MatiasV98/camara-cultivo-hongos-esp32/datos/crudos/Prueba_Pi_Clasico_Final.txt

⚙️ Configuración - Setpoint: 25.0°C, Kc: 0.650, Ti: 2200s, Ts: 2s, Period: 10000ms

TYPE,Time(s),Temperature(C),Setpoint(C),Error(C),ControlSignal,Integral,RelayState,OnTime(s)
INICIO,0.0,22.69,25.0,0.0,0.000,0,0,0.0
DATA,0.0,22.69,25.0,2.31,1.000,5,0,0.0
🔄 Relay State: OFF | Tiempo en periodo: 0.0s | OnTime: 0.0s
DATA,2.0,22.69,25.0,2.31,1.000,9,0,0.0
🌡️ Temp: 22.69°C | Setpoint: 25.0°C | Error: 2.31
DATA,4.0,22.69,25.0,2.31,1.000,14,0,0.0
🔄 Relay State: OFF | Tiempo en periodo: 5.0s | OnTime: 0.0s
DATA,6.0,22.69,25.0,2.31,1.000,19,0,0.0
DATA,8.0,22.69,25.0,2.31,1.000,23,0,0.0
🔧 Control - Error: 2.31 | Control Signal: 1.000 | OnTime: 10.0s
CLASICO,10.1,22.69,25.0,2.31,1.000,28,0,10.0
DATA,10.1,22.69,25.0,2.31,1.000,28,0,10.0
🔄 Relay State: OFF | Tiempo en periodo: 0.0s | OnTime: 10.0s
🔥 Relay ACTIVADO
DATA,12.1,22.69,25.0,2.31,1.000,32,1,10.0
🌡️ Temp: 22.69°C | Setpoint: 25.0°C | Error: 2.31
DATA,14.1,22.69,25.0,2.31,1.000,37,1,10.0
🔄 Relay State: ON | Tiempo en periodo: 5.0s | OnTime: 10.0s
DATA,16.1,22.69,25.0,2.31,1.000,42,1,10.0
DATA,18.1,22.69,25.0,2.31,1.000,46,1,10.0
🔧 Control - Error: 2.31 | Control Signal: 1.000 | OnTime: 10.0s
CLASICO,20.1,22.69,25.0,2.31,1.000,51,1,10.0
DATA,20.1,22.69,25.0,2.31,1.000,51,1,10.0
🔄 Relay State: ON | Tiempo en periodo: 0.0s | OnTime: 10.0s
DATA,22.1,22.69,25.0,2.31,1.000,56,1,10.0
🌡️ Temp: 22.69°C | Setpoint: 25.0°C | Error: 2.31
DATA,24.1,22.69,25.0,2.31,1.000,60,1,10.0
🔄 Relay State: ON | Tiempo en periodo: 5.0s | OnTime: 10.0s
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
DATA,2753.6,25.19,25.0,-0.19,0.059,613,0,0.0
DATA,2755.6,25.19,25.0,-0.19,0.059,613,0,0.0
🔧 Control - Error: -0.19 | Control Signal: 0.059 | OnTime: 0.0s
CLASICO,2757.6,25.19,25.0,-0.19,0.059,612,0,0.0
DATA,2757.6,25.19,25.0,-0.19,0.059,612,0,0.0
🔄 Relay State: OFF | Tiempo en periodo: 1.0s | OnTime: 0.0s
DATA,2759.6,25.19,25.0,-0.19,0.059,612,0,0.0
🌡️ Temp: 25.19°C | Setpoint: 25.0°C | Error: -0.19
DATA,2761.6,25.19,25.0,-0.19,0.059,612,0,0.0
FIN,2762,25.19,25.0,-0.19,0.059,612,0,0.0
==========================================
⏹️ CONTROL DETENIDO
🌡️ Temperatura final: 25.19°C
📊 Muestras recolectadas: 1378
==========================================
