MatiasV98/camara-cultivo-hongos-esp32/datos/crudos/Prueba_6h.txt

🔬 SISTEMA DE IDENTIFICACIÓN TÉRMICA COMPLETA
==========================================
📟 Sensores DS18B20 detectados: 1
✅ Sensor configurado a 12 bits
🌡️ Temperatura inicial: 21.06°C
📡 Access Point: ESP32-Identificacion
🌐 IP: 192.168.4.1
✅ Servidor web iniciado

💡 NUEVA FUNCIONALIDAD:
• Fase 1: Calentamiento (Peltier ON) por tiempo configurado
• Fase 2: Enfriamiento (Peltier OFF) por tiempo configurado
• Curva completa del sistema térmico
• Análisis de simetría calentamiento/enfriamiento
• Datos por Serial con indicador de fase (C/E)

🎯 Sistema listo - Ve a la IP mostrada arriba
==========================================

⚙️ Configuración - Calentamiento: 360 min, Enfriamiento: 1 min, Intervalo: 5 seg

🚀 INICIANDO PRUEBA COMPLETA DE IDENTIFICACIÓN
==========================================
⏰ Fase Calentamiento: 360 minutos
⏰ Fase Enfriamiento: 1 minutos
📊 Intervalo de muestreo: 5 segundos
Tiempo(s),Temperatura(C),Fase
0.0,21.06,C
1.3,21.06,C
6.3,21.06,C
11.3,21.06,C
16.3,21.06,C
21.3,21.06,C
26.4,21.06,C
31.4,21.06,C
36.4,21.06,C
41.4,21.06,C
46.4,21.06,C
51.4,21.06,C
56.4,21.06,C
61.4,21.06,C
66.4,21.06,C
71.4,21.06,C
76.4,21.12,C
81.4,21.12,C
86.4,21.12,C
91.4,21.12,C
96.4,21.19,C
101.4,21.25,C
106.4,21.25,C
111.4,21.31,C
116.5,21.38,C
121.5,21.44,C
126.5,21.44,C
131.5,21.50,C
136.5,21.56,C
141.5,21.56,C
146.5,21.62,C
151.5,21.69,C
156.5,21.69,C
161.5,21.69,C
166.5,21.75,C
171.5,21.75,C
176.5,21.81,C
181.5,21.88,C
186.5,21.88,C
191.5,21.94,C
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

==========================================
✅ PRUEBA COMPLETA FINALIZADA
⏰ Tiempo total: 21668.5 segundos
🌡️ Temperatura final: 45.25°C
📊 Muestras recolectadas: 4332
📈 Ganancia en calentamiento: 24.25°C
==========================================
