MatiasV98/camara-cultivo-hongos-esp32/datos/crudos/Prueba_Final_PI_IMC.txt

=
ðŸŽ›ï¸ INICIANDO CONTROLADOR PI
==========================================
ðŸŽ¯ Setpoint: 25.0Â°C
ðŸ”§ ParÃ¡metros - Kc: 0.600, Ti: 2200s, Ts: 2s
â° Periodo control: 10000ms
TYPE,Time(s),Temperature(C),Setpoint(C),Error(C),ControlSignal,Integral,RelayState,OnTime(s)
INICIO,0.0,22.00,25.0,0.0,0.000,0,0,0.0
DATA,0.0,22.00,25.0,3.00,1.000,6,0,0.0
DATA,2.0,22.00,25.0,3.00,1.000,12,0,0.0
DATA,4.0,22.00,25.0,3.00,1.000,18,0,0.0
DATA,6.1,22.00,25.0,3.00,1.000,24,0,0.0
DATA,8.1,22.00,25.0,3.00,1.000,30,0,0.0
CONTROL,10.1,22.00,25.0,3.00,1.000,36,0,10.0
DATA,10.1,22.00,25.0,3.00,1.000,36,0,10.0
DATA,12.1,22.00,25.0,3.00,1.000,42,1,10.0
DATA,14.1,22.00,25.0,3.00,1.000,48,1,10.0
DATA,16.1,22.00,25.0,3.00,1.000,54,1,10.0
DATA,18.1,22.00,25.0,3.00,1.000,60,1,10.0
CONTROL,20.1,22.00,25.0,3.00,1.000,66,0,10.0
DATA,20.1,22.00,25.0,3.00,1.000,66,0,10.0
DATA,22.1,22.00,25.0,3.00,1.000,72,1,10.0
DATA,24.1,22.00,25.0,3.00,1.000,78,1,10.0
DATA,26.1,22.00,25.0,3.00,1.000,84,1,10.0
DATA,28.1,22.00,25.0,3.00,1.000,90,1,10.0
CONTROL,30.1,22.00,25.0,3.00,1.000,96,0,10.0
DATA,30.1,22.00,25.0,3.00,1.000,96,0,10.0
DATA,32.2,22.00,25.0,3.00,1.000,102,1,10.0
DATA,34.2,22.00,25.0,3.00,1.000,108,1,10.0
DATA,36.2,22.00,25.0,3.00,1.000,114,1,10.0
DATA,38.2,22.00,25.0,3.00,1.000,120,1,10.0
CONTROL,40.2,22.00,25.0,3.00,1.000,126,0,10.0
DATA,40.2,22.00,25.0,3.00,1.000,126,0,10.0
DATA,42.2,22.00,25.0,3.00,1.000,132,1,10.0
DATA,44.2,22.00,25.0,3.00,1.000,138,1,10.0
DATA,46.2,22.00,25.0,3.00,1.000,144,1,10.0
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
DATA,2193.1,25.25,25.0,-0.25,0.078,835,0,0.0
DATA,2195.1,25.25,25.0,-0.25,0.078,834,0,0.0
DATA,2197.1,25.25,25.0,-0.25,0.077,834,0,0.0
CONTROL,2199.1,25.25,25.0,-0.25,0.077,833,0,0.0
DATA,2199.1,25.25,25.0,-0.25,0.077,833,0,0.0
DATA,2201.1,25.25,25.0,-0.25,0.077,833,0,0.0
DATA,2203.1,25.25,25.0,-0.25,0.077,832,0,0.0
FIN,2204,25.25,25.0,-0.25,0.077,832,0,0.0
==========================================
â¹ï¸ CONTROL DETENIDO
ðŸŒ¡ï¸ Temperatura final: 25.25Â°C
ðŸ“Š Muestras recolectadas: 1098
==========================================
