MatiasV98/camara-cultivo-hongos-esp32/datos/crudos/Prueba_PI.txt

ðŸŽ›ï¸ INICIANDO CONTROLADOR PI
==========================================
ðŸŽ¯ Setpoint: 22.0Â°C
ðŸ”§ ParÃ¡metros - Kc: 0.700, Ti: 2403s, Ts: 2s
â° Periodo control: 10000ms
TYPE,Time(s),Temperature(C),Setpoint(C),Error(C),ControlSignal,Integral,RelayState,OnTime(s)
INICIO,0.0,19.75,22.0,0.0,0.000,0,0,0.0
DATA,0.0,19.75,22.0,2.25,1.000,5,0,10.0
DATA,2.0,19.81,22.0,2.19,1.000,9,1,10.0
DATA,4.1,19.81,22.0,2.19,1.000,13,1,10.0
DATA,6.1,19.81,22.0,2.19,1.000,18,1,10.0
DATA,8.1,19.87,22.0,2.12,1.000,22,1,10.0
CONTROL,10.9,19.87,22.0,2.12,1.000,26,0,10.0
DATA,10.1,19.87,22.0,2.12,1.000,26,0,10.0
DATA,12.1,19.87,22.0,2.12,1.000,30,1,10.0
DATA,14.1,19.87,22.0,2.12,1.000,35,1,10.0
DATA,16.1,19.87,22.0,2.12,1.000,39,1,10.0
DATA,18.1,19.94,22.0,2.06,1.000,43,1,10.0
ÿÿÿÿÿÿÿÿÿÿÿÿÿÿÿÿÿÿÿÿÿÿÿÿÿÿÿÿÿÿÿÿÿÿÿÿÿÿÿÿÿÿÿÿÿÿÿÿÿÿÿÿÿÿÿÿÿÿÿÿÿÿÿÿONTROL,20.9,19.94,22.0,2.06,1.000,47,1,10.0
DATA,20.1,19.94,22.0,2.06,1.000,47,1,10.0
DATA,22.1,20.00,22.0,2.00,1.000,51,1,10.0
DATA,24.1,20.00,22.0,2.00,1.000,55,1,10.0
DATA,26.1,20.00,22.0,2.00,1.000,59,1,10.0
DATA,28.1,20.00,22.0,2.00,1.000,63,1,10.0
CONTROL,30.9,20.00,22.0,2.00,1.000,67,1,10.0
DATA,30.1,20.00,22.0,2.00,1.000,67,1,10.0
DATA,32.2,20.00,22.0,2.00,1.000,71,1,10.0
DATA,34.2,20.06,22.0,1.94,1.000,75,1,10.0
DATA,36.2,20.06,22.0,1.94,1.000,79,1,10.0
DATA,38.2,20.06,22.0,1.94,1.000,83,1,10.0
CONTROL,41.0,20.12,22.0,1.87,1.000,87,1,10.0
DATA,40.2,20.12,22.0,1.87,1.000,87,1,10.0
DATA,42.2,20.12,22.0,1.87,1.000,90,1,10.0
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
DATA,2240.5,22.12,22.0,-0.13,0.154,827,0,0.0
FIN,2243,22.12,22.0,-0.13,0.154,827,0,0.0
==========================================
â¹ï¸ CONTROL DETENIDO
ðŸŒ¡ï¸ Temperatura final: 22.12Â°C
ðŸ“Š Muestras recolectadas: 1118
==========================================
