MatiasV98/camara-cultivo-hongos-esp32/datos/identificacion/prueba1_100min.csv

Tiempo_s | Temperatura_C
0 | 16.12
1.1 | 16.19
3.2 | 16.12
5.2 | 16.12
7.2 | 16.19
9.2 | 16.12
11.2 | 16.19
13.2 | 16.12
15.2 | 16.19
17.2 | 16.19
19.2 | 16.12
21.2 | 16.19
23.2 | 16.12
25.2 | 16.12
27.2 | 16.12
29.2 | 16.12
31.2 | 16.19
33.3 | 16.12
35.3 | 16.19
37.3 | 16.19
39.3 | 16.19
41.3 | 16.19
43.3 | 16.19
45.3 | 16.19
47.3 | 16.19
49.3 | 16.25
51.3 | 16.25
53.3 | 16.25
55.3 | 16.31
57.3 | 16.31
59.3 | 16.31
61.3 | 16.31
63.3 | 16.31
65.3 | 16.31
67.3 | 16.31
69.3 | 16.31
71.3 | 16.31
73.4 | 16.31
75.4 | 16.31
77.4 | 16.25
79.4 | 16.25
81.4 | 16.25
83.4 | 16.25
85.4 | 16.25
87.4 | 16.25
89.4 | 16.25
91.4 | 16.31
93.4 | 16.31
95.4 | 16.31
97.4 | 16.31
99.4 | 16.38
101.4 | 16.38
103.4 | 16.38
105.4 | 16.44
107.4 | 16.38
109.4 | 16.44
111.4 | 16.44
113.5 | 16.5
115.5 | 16.5
117.5 | 16.5
119.5 | 16.56
121.5 | 16.56
123.5 | 16.56
125.5 | 16.62
127.5 | 16.56
129.5 | 16.62
131.5 | 16.62
133.5 | 16.69
135.5 | 16.69
137.5 | 16.69
139.5 | 16.69
141.5 | 16.75
143.5 | 16.81
145.6 | 16.81
147.6 | 16.81
149.6 | 16.81
151.6 | 16.88
153.6 | 16.81
155.6 | 16.88
157.6 | 16.94
159.6 | 16.94
161.6 | 16.94
163.6 | 16.94
165.6 | 16.94
167.6 | 17
169.6 | 17
171.6 | 17
173.6 | 17
175.6 | 17
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
