MatiasV98/camara-cultivo-hongos-esp32/datos/identificacion/prueba2_240min.csv

Tiempo_s | Temperatura_C
0 | 17.88
1.2 | 17.88
3.2 | 17.88
5.2 | 17.81
7.2 | 17.88
9.2 | 17.88
11.2 | 17.81
13.2 | 17.88
15.2 | 17.88
17.2 | 17.88
19.2 | 17.81
21.2 | 17.81
23.2 | 17.88
25.2 | 17.88
27.2 | 17.81
29.3 | 17.88
31.3 | 17.88
35.3 | 17.88
37.3 | 17.81
39.3 | 17.88
41.3 | 17.81
43.3 | 17.88
45.3 | 17.88
47.3 | 17.88
49.3 | 17.88
51.3 | 17.81
53.3 | 17.88
55.3 | 17.88
57.3 | 17.88
59.3 | 17.88
61.4 | 17.88
63.4 | 17.88
65.4 | 17.88
67.4 | 17.88
69.4 | 17.88
71.4 | 17.81
73.4 | 17.88
77.4 | 17.88
79.4 | 17.88
83.4 | 17.88
85.4 | 17.94
87.4 | 17.94
89.4 | 17.94
91.4 | 17.94
93.4 | 18
95.4 | 18
97.4 | 18
99.4 | 18
101.4 | 18.06
103.4 | 18.06
105.4 | 18.12
107.5 | 18.12
109.5 | 18.12
111.5 | 18.19
113.5 | 18.19
115.5 | 18.19
117.5 | 18.25
119.5 | 18.25
121.5 | 18.25
123.5 | 18.31
125.5 | 18.31
127.5 | 18.31
129.5 | 18.31
131.5 | 18.38
133.5 | 18.38
135.6 | 18.38
137.6 | 18.38
139.6 | 18.44
141.6 | 18.44
143.6 | 18.44
145.6 | 18.44
147.6 | 18.5
149.6 | 18.5
151.6 | 18.5
153.6 | 18.5
155.6 | 18.56
157.7 | 18.56
161.7 | 18.56
163.7 | 18.62
165.7 | 18.62
167.7 | 18.62
169.7 | 18.69
171.7 | 18.69
173.7 | 18.69
175.7 | 18.69
177.7 | 18.69
179.8 | 18.75
181.8 | 18.75
183.8 | 18.75
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
