MatiasV98/camara-cultivo-hongos-esp32/datos/identificacion/prueba3_360min_completa.csv

Tiempo_s | Temperatura_C | Fase
0 | 21.06 | C
1.3 | 21.06 | C
6.3 | 21.06 | C
11.3 | 21.06 | C
16.3 | 21.06 | C
21.3 | 21.06 | C
26.4 | 21.06 | C
31.4 | 21.06 | C
36.4 | 21.06 | C
41.4 | 21.06 | C
46.4 | 21.06 | C
51.4 | 21.06 | C
56.4 | 21.06 | C
61.4 | 21.06 | C
66.4 | 21.06 | C
71.4 | 21.06 | C
76.4 | 21.12 | C
81.4 | 21.12 | C
86.4 | 21.12 | C
91.4 | 21.12 | C
96.4 | 21.19 | C
101.4 | 21.25 | C
106.4 | 21.25 | C
111.4 | 21.31 | C
116.5 | 21.38 | C
121.5 | 21.44 | C
126.5 | 21.44 | C
131.5 | 21.5 | C
136.5 | 21.56 | C
141.5 | 21.56 | C
146.5 | 21.62 | C
151.5 | 21.69 | C
156.5 | 21.69 | C
161.5 | 21.69 | C
166.5 | 21.75 | C
171.5 | 21.75 | C
176.5 | 21.81 | C
181.5 | 21.88 | C
186.5 | 21.88 | C
191.5 | 21.94 | C
196.5 | 21.94 | C
201.5 | 22 | C
206.5 | 22.06 | C
211.5 | 22.06 | C
216.5 | 22.12 | C
221.6 | 22.19 | C
226.6 | 22.19 | C
231.6 | 22.25 | C
236.6 | 22.31 | C
241.6 | 22.31 | C
246.6 | 22.38 | C
251.6 | 22.44 | C
256.6 | 22.44 | C
261.6 | 22.5 | C
266.6 | 22.5 | C
271.6 | 22.56 | C
276.6 | 22.56 | C
281.6 | 22.62 | C
286.6 | 22.62 | C
291.6 | 22.69 | C
296.6 | 22.69 | C
301.6 | 22.75 | C
306.6 | 22.81 | C
311.6 | 22.81 | C
316.6 | 22.88 | C
321.6 | 22.88 | C
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
