MatiasV98/camara-cultivo-hongos-esp32/(commit log)

2026-11-01 Firmware PI IMC (ESP32)
2026-11-01 Firmware con selección IMC / clásico (ESP32)
2026-11-01 Scripts de MATLAB: limpieza, ajuste FOPTD, Bode y LGR
2026-11-01 Datos de los ensayos al escalón (identificación)
    [prueba1_100min.csv, prueba2_240min.csv, prueba3_240min.csv, prueba3_360min_completa.csv]
2026-11-01 Datos de los ensayos con PI en lazo cerrado
    [pi_kc0.65_ti2200_sp25.csv, pi_kc0.6_ti2200_sp25.csv, pi_kc0.7_ti2400_sp22.csv]
2026-11-01 Registros seriales originales del ESP32
2026-11-01 README: el proyecto es la cámara de cultivo de hongos
2026-11-07 README: métricas de los ensayos, actuador y ajuste en planta; firmware sin emojis
    - Tabla con llegada a la consigna, máximo sobre SP, recuperación ante la
    perturbación y estado final, calculados de los CSV de lazo cerrado.
    - Se explica que el relé quedó en todo-nada (período 10 s, mínimos de 5 s)
    y por qué las ganancias en planta superan a las de diseño.
    - Notación K_c (IMC) / K_p (clásico) igual a la del informe.
    - Mensajes seriales y página web del ESP32 sin emojis.
2026-11-07 README: sección de contacto con el mismo formato que los demás repositorios
